Bop179/tiered-wakeup-visual-classification/analysis/figures/pareto.png

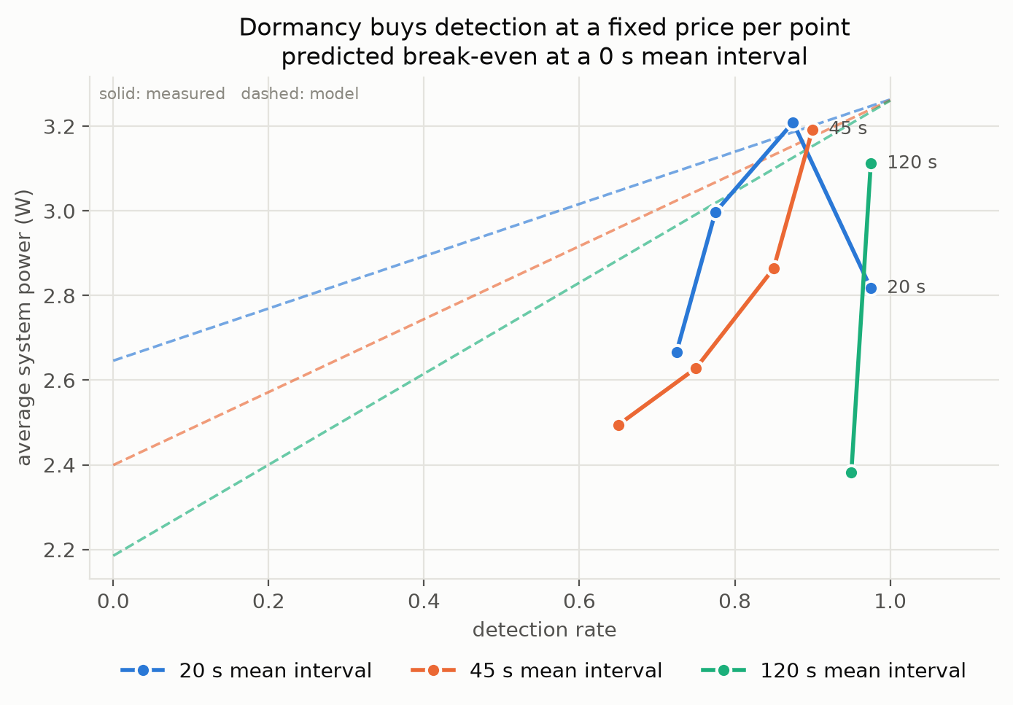
analysis/figures/pareto.png
