Bop179/tiered-wakeup-visual-classification/analysis/figures/Tier 1 Schematic.jpeg

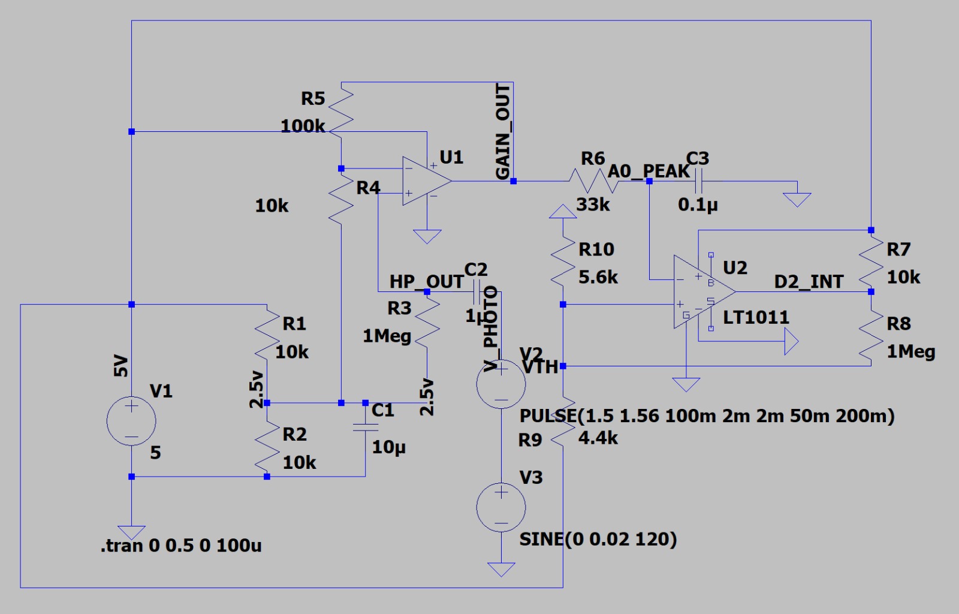
analysis/figures/Tier 1 Schematic.jpeg
