Bop179/tiered-wakeup-visual-classification/analysis/figures/Tier 1 Simulation.jpeg

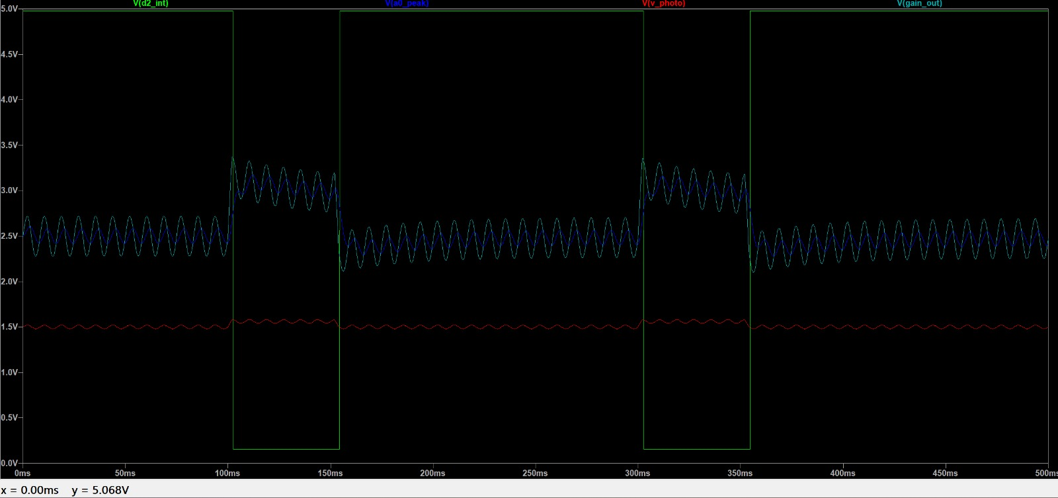
analysis/figures/Tier 1 Simulation.jpeg
