Bop179/tiered-wakeup-visual-classification/analysis/figures/trace.png

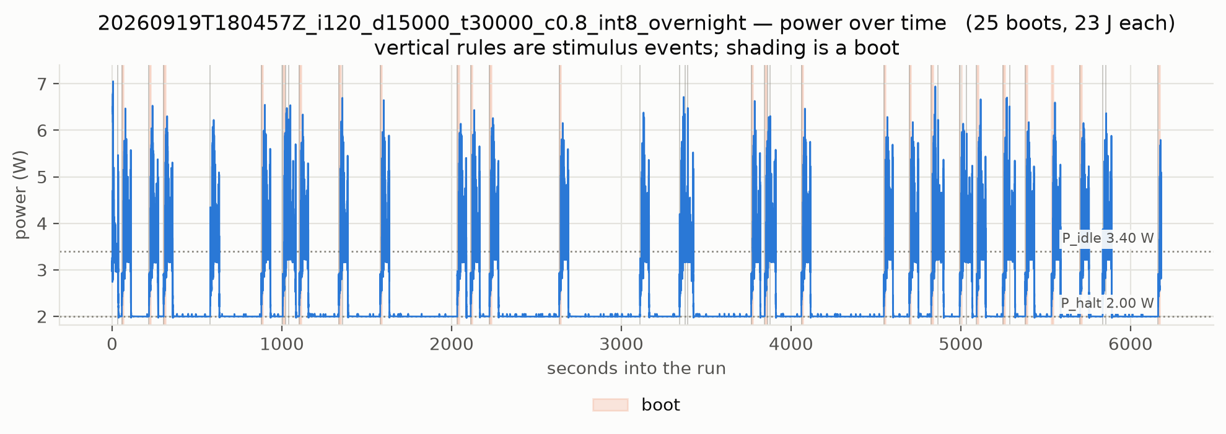
analysis/figures/trace.png
