Bop179/tiered-wakeup-visual-classification/(commit log)

2026-09-05 Scaffold the repo as the shared source of truth
    Everything up to now lived in chat transcripts and a stale local brief. This
    makes the repo canonical so the Tier 2 owner can pull the revised Tier 0/1 spec — the
    sensor changed from an IR beam-break to a visible-light change detector, and
    event_generator.ino is cancelled.
    Contract, which both halves code against:
    docs/INTERFACE.md frozen serial protocol, the two ways to destroy a
    Pi, clock reconciliation, log formats, and the
    firmware constants the Tier 2 owner owns
    docs/TEAMMATE_BRIEF.md Tier 0 analog chain and Tier 1 spec
    docs/EXPERIMENTS.md priority-ordered matrix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
    [events.csv, gen.csv, power.csv]
2026-09-05 Make the swept Tier 1 constants settable at runtime, and extend the Tier 2 owner's brief
    The dormancy timeout is the swept variable of the headline experiment: six
    values across four event rates, 24 cells over Sep 14-16. As a compile-time
    constant that meant a reflash per cell -- the Tier 2 owner physically at the rig for three
    days -- and a manifest that could only record what we claimed was flashed.
    Add SET/GET/CFG to the contract (INTERFACE.md 1.1). CFG reports the value in
    effect rather than the value requested, clamping out of range, so a typo or a
    clamp lands in the run record instead of silently mislabelling a cell.
    run_experiment.py now passes --dormancy-ms to the daemon, which sets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
2026-09-05 Renumber the tiers 0/1/2 -> 1/2/3
    Analog trigger becomes Tier 1, the Arduino Tier 2, the Pi Tier 3. Renamed in
    descending order so no stage was renamed twice, which ascending order would have
    done. Compound forms ("Tier 0/1"), the README table's bare-digit cells, and the
    Tier1<->Tier2 shorthand each needed handling separately; INT0 sits in the same
    table row as a tier digit and is untouched.
    Paths follow the numbering: firmware/tier1_firmware/ -> firmware/tier2_firmware/
    and data/tier0_roc.csv -> data/tier1_roc.csv, which analysis/plots.py reads.
    TEAMMATE_BRIEF.md gains section 0.0, because the old and new schemes overlap and
    that is a trap rather than a cosmetic change: in the brief the T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
    [classify.py, event_display.py, latency_bench.py, mock_arduino.py, pi_daemon.py, plots.py, power_model.py, run_experiment.py]
2026-09-06 Fix the off-by-one that would have zeroed every accuracy number
    Running the Mac stack against real dependencies for the first time (setup_mac.sh
    and fetch_models.sh had never been run) surfaced a contradiction between the
    model we ship and the manifest format images/README.md told us to author.
    mobilenet_v2_1.0_224_quant.tflite emits 1001 classes: ImageNet's 1000 plus
    "background" at index 0. Every real class therefore sits one higher than the
    1000-class space that torchvision, the usual class-list gists and most papers
    quote. classify.py already handles this correctly and resolves banana to 955.
    images/README.md told us to write 954, and 504 for coffee mug -- both in the
    other space. In th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
    [classify.py, make_synthetic_run.py, pi_daemon.py, reference_predict.py]
2026-09-06 Build the stimulus set, and measure the accuracy ceiling at 64.4%
    images/ was the last thing blocking the Pi measurements: reference_predict.py
    cannot produce an accuracy ceiling without it, and without the ceiling every
    on-Pi accuracy number is unattributable.
    tools/fetch_stimulus.py pulls real ILSVRC-2012 validation JPEGs from the
    evanarlian/imagenet_1k_resized_256 mirror -- the official imagenet-1k repo is
    gated, that one is not. Its validation split is sorted by label at exactly 50
    images per class, so a class lives at rows [c*50, c*50+50) and no per-row
    filtering is needed; the datasets-server /filter endpoint is returning 500 in any
    case. Images arrive at 256 on the short side, which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
    [fetch_stimulus.py]
2026-09-11 Keep the daemon alive across halts, score accuracy, and give Tier 1 its own stimulus
    Three builds from the runbook, plus the run lifecycle they needed.
    1. The daemon survives a halt. It ran under nohup, so the first HALT in a cell
    ended it for good and every later event would have logged as a miss -- 20 of
    the 24 primary cells and the whole duration sweep. pi/tier3-daemon.service
    (pi/install_service.sh) runs pi/run_current.sh at every boot while
    data/current_run.env exists. On a restart the daemon resumes event_idx
    instead of reusing 0, 1, 2 in the same events.csv; skips the clapperboard,
    which runs before "# ready" and would otherwise add to every measured boot;
    and ap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
    [accuracy.py, event_display.py, make_synthetic_run.py, pi_daemon.py, plots.py, run_experiment.py, trigger_patch.py]
2026-09-12 Measure Gate 0.4: E_boot 37.1 J net, P_halt 2.0 W, break-even 3.9 s
    find_levels drops transit slivers before the dwell test, a 1 s boxcar is used
    for state detection only, and --boot-cycle brackets boots by edges using the
    daemon's uptime. EXPERIMENTS.md section 0 holds every measured constant.
2026-09-12 Run the model on a blank frame for --real-infer without --camera
    The daemon loaded the model but fell through to the fake banana result.
2026-09-13 Size the case fans: 0.72 W halted, 0.65 W idle
    A fanless halted floor is 1.27 W, so the fans explain a third of the gap to
    the 0.5 W estimate and the SoC the rest.
2026-09-13 Send EVT and wake at PERSIST, not on release; one EVT per assertion
    The firmware kept timing a held trigger until release (up to 5 s) before
    queuing the event, so with 15 s stimulus patches every EVT and every wake pulse
    would have been 5 s late. duration_ms is the hold before acceptance, as
    INTERFACE section 1 says. REFRACTORY now runs from the last moment the trigger
    was seen asserted, so a held trigger gives one EVT and contact bounce cannot
    re-arm it. Bench-verified on the Uno with a button and a D7 LED: one EVT per
    3 s hold, wake pulse at press, held EVT sent after # ready.
    mock_pi.py --serve gains --dormancy-ms for bench tests.
2026-09-13 Wake line series resistor 330 Ω, not 1 kΩ; add wirecheck sketch
    1 kΩ against the Pi's 1.8 kΩ pull-up leaves GPIO3 at 1.18 V when
    asserted, above the LOW threshold. 330 Ω measured 0.52 V on the bench
    with a 1.8 kΩ stand-in; TX divider 3.25 V.
2026-09-13 Record Tier 2 <-> Pi integration (s12b/s12c); arduino_t_ms freezes in deep sleep
    Wirecheck voltages, wake pulse on GPIO3, two full halt/wake/EVT cycles.
    PWR_DOWN stops millis(), so accuracy.py's single clock fit does not hold
    for cells that halt -- noted as an open item in INTERFACE section 4.
2026-09-13 s12d metered boot; fix --boot-cycle kernel threshold without a firmware level
    The fallback (halt+idle)/2 threshold sat on the ~2.65 W firmware plateau
    and put the kernel start 4 s into a 9.5 s stage. Read the plateau off
    1-4 s after each wake instead. Gate 0.4 trace unchanged (88.5 J, 9.50 s),
    synthetic round-trip passes. s12d: T_boot 20.8 s, E_boot 26.6 J net.
    [energy_analysis.py]
2026-09-18 Add live camera preview for aiming and focusing
    pi/preview.py serves MJPEG on the Pi's localhost:8000 with the daemon's fixed
    exposure (--auto for auto exposure) and refuses while tier3-daemon owns the
    camera. tools/preview.sh tunnels it over SSH and opens the browser.
    [preview.py]
2026-09-18 Per-sleep-epoch clock fit; fix boot pairing when a trace opens awake
    accuracy.py: arduino_t_ms freezes while the Uno sleeps, so one global
    offset cannot pair a halting cell. fit_epochs() fits an offset per sleep
    epoch, anchored on the booted row (the firmware stamps the held EVT at
    detection). Self-test E covers a halting cell.
    energy_analysis.py: boot_cycle_windows paired wakes to "# ready" uptimes
    by index. A trace that starts with the Pi already up has one ready with
    no wake, which shifted every boot by one. s18_tboot (n=4): T_boot
    38.8 s -> 22.3 s (20.7-26.8), E_boot 74.1 J, net of halt 29.6 J.
    s12d_metered is unchanged.
    [accuracy.py, energy_analysis.py]
2026-09-18 Trace figure shades the integrated boot windows; README carries measured constants
    energy_analysis writes boot_windows_t to summary.json and plots.py shades
    those, instead of re-detecting boots by level (which spanned whole awake
    windows on edge-bracketed runs).
2026-09-18 Clapperboard search anchored on the ssh-predicted time
    A trace that opens below idle made plain idle a +0.8 W step, so a 1.4 s idle
    stretch passed for the burn 2.9 s early (harness run). With the ssh offset
    known, look only within 2 s of the prediction and take the baseline from just
    before it. Also records the harness run in EXPERIMENTS.md.
    [energy_analysis.py]
2026-09-18 Lock camera white balance; lead-in covers the macOS fullscreen transition
    AwbEnable False with no ColourGains left unity gains: a cyan cast under which
    every harness event classified as none. Locked at AWB's (3.38, 1.55) the same
    banana reads 0.99. Camera probe also showed the fullscreen window reaching the
    screen 6-8 s after it is drawn, so lead-in 3 s -> 10 s, and the release wake
    flash 1 s -> 10 s, or Tier 1 never sees it.
2026-09-19 Never-halt runs: no halt or boot states when dormancy -1 is verified
    Awake workloads sit at several power levels; with dormancy -1 verified none
    of them is a halt or a boot. The trace figure falls back to the analyser's
    own state rules when the summary is missing.
    Claude-Session: https://claude.ai/code/session_01GxG95Gem4xoRnbrDPZkfQw
    [energy_analysis.py, plots.py, test_energy_analysis.py]
2026-09-19 Tier 1 on the rig: LDR trigger, PERSIST 10 ms, larger patch and images
    - Firmware: PERSIST default 40 -> 10 ms; rejected triggers log "# t2: noise N ms".
    mock_pi conformance and INTERFACE section 6 follow.
    - trigger_patch: echoes Uno lines, answers any "wake" with "# ready" +
    SET,DORMANCY,-1 so one missed handshake cannot hold every EVT.
    - Patch bottom-left at 0.25 of the short edge; images use the full height
    between the patch columns (674x314 -> 674x684 on the rig display).
    - Overnight image duration 10 -> 15 s (~0.7 T_boot, still under a boot).
    - INTERFACE 2.4: USB-power rules while Pi pin 8 drives D0.
    - a0scope: A0/D2 bench sketch for the Serial Plotter.
    - EXPERIMENTS: rehearsal ro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
    [a0scope.ino, event_display.py, mock_pi.py, run_experiment.py, tier2_firmware.ino, trigger_patch.py]
2026-09-19 Overnight matrix measured: all 10 cells into the pre-registered table
    - REPORT section 3: measured power and awake-detection beside the Sep 18
    predictions; the run used 15 s images, which the model maps to the same table
    as 10 s (both shorter than T_boot). Notes the two departures: onsets are
    15 s + Exp(interval) apart, and back-to-back images merge into one trigger.
    - overnight.sh takes a count of cells to skip, used to resume after the Pi
    dropped off Wi-Fi at the end of cell 5.
    - EXPERIMENTS: rows for the 10 overnight cells.
    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
2026-09-19 Ignore the two regenerated outputs left in the working tree
    - tools/gen.csv: event_display.py's --out defaults to the cwd, same trap as
    mock_events.csv. The gen.csv that matters is in each run directory.
    - analysis/figures/: plots.py regenerates it and no doc embeds trace.png.
    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
2026-09-19 Video-gating analysis: figures, prediction check, and the Tier 1 write-up
    The result the matrix actually produced: T_boot (20.8 s) outlives the stimulus
    (15 s), so a Pi woken by an event boots into a blank screen. Detection holds up
    and end-to-end accuracy collapses -- 0.525-0.550 never-halt against 0.025-0.400
    halting, on a 0.700 ceiling. REPORT section 4.1 states it as the project's
    finding and names the three fixes that were out of scope.
    - plots.py: --tag keeps the rehearsals out of the matrix figures; the trace
    fallback honours it too. Without this the Pareto mixed two populations.
    - pareto.png and trace.png committed: plots.py rebuilds them from data/, but
    data/ is gitignored, so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
    [plots.py]
2026-09-20 Meter the cascade's own cost: Uno awake/asleep, and the net-positive answer
    The FNB58 went inline in the Uno's wall-USB lead. One continuous log across a
    power-cycle captures both plateaus and the transition between them:
    awake idle 31.24 mA @ 5.332 V 167 mW
    power-down sleep 16.77 mA @ 5.336 V 89 mW
    The step lands at t = 52 s, which is 30 s dormancy + 2 s ACK timeout + 20 s
    HALT_SETTLE_MS. That timing is what licenses calling the lower plateau sleep;
    two separate readings could not have. mean(V*I) and dE/dt agree at 89.5 mW.
    Tier 1 is fed from the Uno's 5V pin, so its ~2.4 mA sits inside both figures
    and does not sleep with the MCU. The Uno-alone rows subtract it.
    This s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
2026-09-20 Log Tier 2's diagnostics instead of dropping them
    The daemon's main loop discarded every line starting with '#', which is
    exactly where Tier 2 says what went wrong: "# t2: no ACK -- assuming halted",
    "# t2: boot timeout -- re-asserting wake once", "# t2: noise <n> ms". Nothing
    captured the Uno's side of the link, so the 6-of-40 post-boot misses in the
    overnight matrix could not be explained from the logs, and tonight's demo take
    has two events that produced no EVT with no record of why.
    Now prefixed "# t2rx" and printed to daemon.log.
    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
    [pi_daemon.py]
2026-09-20 Keep tonight's demo measurements in the repo
    data/* is gitignored, so every number taken tonight lived on one machine.
    Force-added the small ones the video and write-up depend on:
    uno_sleep_awake/ the 31.24 mA / 16.77 mA plateaus and the 52 s sleep step
    *_beat1/ awake path, banana 0.941 at 31 ms
    *_demoA2/ the halt step at 22 s and two boots into an expired stimulus
    *_demoA/ the stale-Uno failure, kept as the counter-example
    demoB/ low-sensitivity take: 6 stimuli, zero triggers, as intended
    The 317 MB overnight matrix stays out; it is too big for git and is still
    only on the Mac.
    gen_unmatched_2209.csv was written to the repo root by an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
    [boots.csv, events.csv, gen.csv, gen_unmatched_2209.csv, lowsens.csv, power.csv, power_sleep.csv]
2026-09-20 Segment 7: rewrite the narration around what Demo B actually measured
    Shot Sep 19, trimmer as the only knob, PERSIST held at 10 ms, capture
    disabled. Three takes:
    as locked 4/4 real flashes, 4 baits rejected (2 logged "noise 4 ms")
    sensitive 94 comparator blips at 0-1 ms, ALL rejected, still 4/4 real
    insensitive zero triggers of any kind
    The script predicted take 2 would produce "EVT after EVT" and a false-positive
    rate "denominated in joules". It produced zero false wakes: every blip was
    under a millisecond and Tier 2's persistence filter discarded all 94 while
    still passing all four real flashes. That is a better result than the
    prediction -- Tier 1 can be badly miscalibrate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
    [gen_normal.csv, gen_sens.csv, gen_unmatched_2320.csv, normal.csv, sens.csv]
2026-09-20 Close out the documentation against what was actually measured
    trigger_characterization.md
    §1 the trimmer wiper voltage is now "deliberately not metered", with the
    reason: it is a function of ambient light and the LDR divider, so it does
    not transfer to another room and is a calibration knob, not a spec.
    §4 no longer "NOT RUN". Three measured threshold points from Demo B replace
    it, with the finding that matters: at a deliberately over-sensitive
    threshold the comparator tripped 94 times in two minutes and PERSIST
    10 ms discarded all 94 while still passing every real flash. A
    miscalibrated Tier 1 produced zero spurious wakes. Noted that the
    lo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
2026-09-20 Move the matrix to a 25 s stimulus, and score the reviewed outcomes
    The 15 s default was picked as ~0.7*T_boot, which guaranteed that any event
    arriving during a 20.8 s boot was lost. 25 s outlasts a boot by ~4.2 s, so
    runner, display, overnight matrix, synthetic generator and the power model all
    default to it; the sample run is regenerated at the new duration.
    accuracy.py now prefers a run's reviewed_events.csv when one exists: reviewed
    classes drive accuracy, the machine figure is kept as logged_accuracy, and
    timing, detection, firing and energy stay machine-measured. It validates the
    review against gen.csv and events.csv rather than trusting it.
    Also adds the corrected Tier 1 netlist an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
    [gen.csv]
2026-09-22 Add a live demo dashboard, and keep video production out of the repo
    tools/live_dashboard.py runs on the laptop next to run_experiment.py: Pi
    state, wake-to-ready boot time, power and energy, and the latest
    classification. State comes from the FNB58 trace, since a halted Pi is off
    the network but still on the meter. The halt threshold sits just above the
    flat 2.00 W halted draw; the midpoint to idle flickered through the first
    ~10 s of every boot, which draws 2.5-2.9 W.
2026-09-25 Drop the teammate brief and stop tracking raw run data
    Only data/sample stays in git, as data/README.md already promised; the
    demo and characterization runs remain on disk but out of the repo.
    [boots.csv, events.csv, gen.csv, gen_normal.csv, gen_sens.csv, gen_unmatched_2209.csv, gen_unmatched_2320.csv, lowsens.csv]
